evanvee/modular-drawers-gridfinity/scene/bin-anatomy.scad

// Left: 2x2 bin FLIPPED to show the magnet pockets in its base.
// Right: same bin upright, tab forward.
translate([-55,0,24.55]) rotate([180,0,0]) color("#C07846") import("../starter/bin-2x2x3.stl");
translate([ 55,0,0])                        color("#8fae8b") import("../starter/bin-2x2x3.stl");
