evanvee/modular-drawers-gridfinity/scene/bin-detail.scad

// Three bins showing the label tab (front overhang) and the scoop ramp.
color("#cf7b5c") translate([  0,0,0]) import("../bins/bin-2x1x6.stl");
color("#8fae8b") translate([100,0,0]) import("../bins/bin-1x1x3.stl");
color("#b9885c") translate([180,0,0]) import("../bins/bin-1x1x6.stl");
