evanvee/modular-drawers-gridfinity/scene/tabcheck.scad

translate([   0,0,0]) color("#cf7b5c") import("../bins/bin-1x1x6.stl");
translate([ 100,0,0]) color("#8fae8b") import("../bins/bin-2x1x6.stl");
translate([ 260,0,0]) color("#b9885c") import("../bins/bin-4x1x6.stl");
