evanvee/modular-drawers-gridfinity/(commit log)

2026-09-11 build: calibrated depth-2 starter config, and the reasoning behind it
    Adds the configuration for one specific build to this fork, so it can be
    reproduced or resumed without re-deriving anything. Upstream is untouched.
    BUILD.md is the resume document. It records what was measured rather than
    assumed: Drawer_Tolerance = 0.5 is calibrated against a printed cross-section
    and stub drawer, not a default; Height_Units steps in 6u increments, not 1u;
    each unit costs 48mm of width and 44mm of depth, not the 42mm Gridfinity
    pitch; style_tab=1 yields a uniform one-unit tab so a single label size fits
    every bin ever printed. It also carries the filament profile and the reason
    for it (215/230 nozzle, be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
    [bin-anatomy.scad, bin-detail.scad, drawer-loaded.scad, sidebyside.scad, tabcheck.scad, tabsection.scad, tower-shallow.scad, tower.scad]
2026-09-11 build: plate 1 measured and verified, tolerance holds
    Housings printed and checked. Inner opening derives to 56.04 against a 56.00
    nominal, so Drawer_Tolerance = 0.5 stands and plates 2 and 3 go as-is.
    Records the measurement trap that nearly caused a needless correction: reading
    the opening directly with caliper internal jaws gave 56.7, because the jaws
    spread walls spanning 195mm. Two signals contradicted it -- the outer dimension
    was only +0.18, and the dovetail interlock was tight, which means internal
    features print small and is incompatible with walls thin enough to explain
    +0.7. Deriving the opening from outer - 2*wall, with wall measured end-on where
    it cannot flex, gives the right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
2026-09-11 build: dovetail interlock verified — hand-assembled, leave constants alone
    Tight on first fit, which is correct: PLA dovetails burnish their layer-line
    high spots over the first few assemblies. Records why NOT to adjust
    dovetail_size or connector_support_tolerance -- they are compatibility-altering
    and would leave new housings unable to mate with the two already printed.
2026-09-13 build: complete — all three plates printed, fit verified
    Two housings, two drawers, eight bins. The configuration is validated end to
    end, from calibration gauge through to assembled module, so render-starter.sh
    output at these settings now reproduces a known-good result rather than a
    proposal.
    Remaining open items are decisions, not unknowns: whether magnets are wanted at
    all (now testable with real bins), and expansion at the same fixed footprint.
2026-09-14 build: V1 frozen, enhancement backlog recorded
    Magnets fitted and working, which closes the last V1 question. Marks the
    configuration frozen so a later session does not treat a compatibility-breaking
    change as a tweak.
    Records the backlog with what actually blocks each item rather than a wish
    list. Notably: divided bins (divx/divy) are the biggest available win and were
    never a decision -- every V1 bin is single-compartment purely because we never
    revisited the default. Drawer self-closing magnets are analysed and blocked on
    geometry, not effort: zero clearance behind a closed drawer, honeycomb back
    walls that cannot take a drilled pocket, and coplanar front faces with nothing
    to attract. L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
2026-09-15 build: operator-selected V2 items, with the divider request reframed
    Three items chosen: drawer magnets, removable divider panels, printed labels.
    The panels request is reframed rather than accepted as stated. Gridfinity bins
    already function as removable dividers at 42mm granularity -- swapping bins
    beats panels, since each compartment lifts out independently. The genuine gap
    is only sub-42mm, where no smaller bin exists. For that, fixed divx/divy
    dividers are free and work today; removable panels need a different bin model
    plus a groove/panel tolerance loop, and a bin costs under an hour to reprint.
    Recommending fixed unless the layout changes weekly.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
2026-09-15 build: hardware drawer plan — 2 x 6u, two levels, one bin per size
    27 categories across two kits, one bin each so every size gets its own label
    tab. Tabs = bins, so a divided bin can never label its compartments -- that is
    what forces one-bin-per-size, and two levels is what makes 27 fit in 16 cells.
    2u chosen over 3u and 1u by capacity: the binding cases are 30x M3*20 bolts and
    40x M3*8*5 inserts at ~12.7k mm^3, against 19.2k in a 2u and 9.6k in a 1u.
    Records the rejected 12u single-drawer option and why: it needs four levels for
    27 categories, so reaching the bottom means lifting three bins, and costs a new
    421g module for worse access. The bins are identical in both plans, so the
    choi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
2026-09-15 build: correct hardware bins to 3u — 2u has no label tab
    The generator suppresses the label tab entirely at 2u and below, regardless of
    style_tab, because the library disables tabs that would take up too much space.
    Verified by differential facet count: style_tab=1 and style_tab=5 (None)
    produce identical geometry at 1u and 2u and diverge at 3u and above.
    The earlier 2u spec was chosen to save 158g and would have produced 27
    unlabelled bins -- defeating the one-bin-per-size decision it was part of.
    Flagged in the file so it is not optimised back.
    Caught by the operator looking at a printed part, not by the model.
2026-09-15 build: bin mass measured at 6.95g, not the 21.1g estimated
    Sliced: 25 bins = 173.72g, 2 bins = 13.96g. 188g and ~18h21m for all 27,
    against a 571g/20h estimate -- 3x over.
    Third time the solid-mesh-volume method has missed on bins and always in the
    same direction. It is accurate on housings and drawers (2% and 0.1% in V1) and
    invalid for small thin-walled hollow parts. V1 flagged it at 29% high for bins;
    it was used again regardless. Recorded as a do-not-estimate rule.
